usevolt/hcu/ce_mark_hcu.pdf

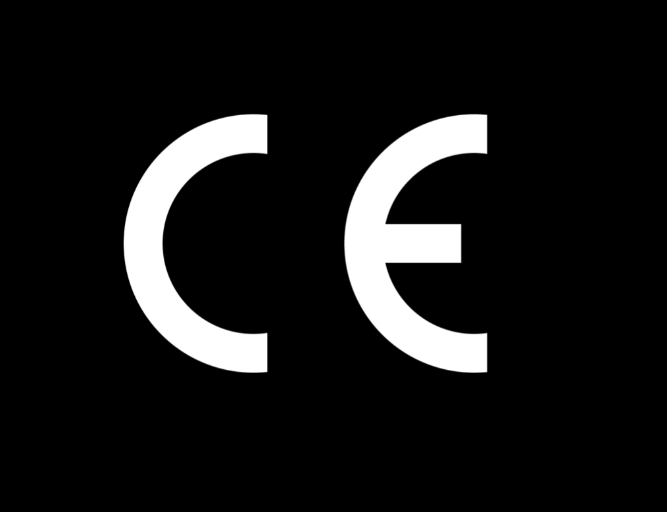
[picture p1: figure]

www.usewood.fi

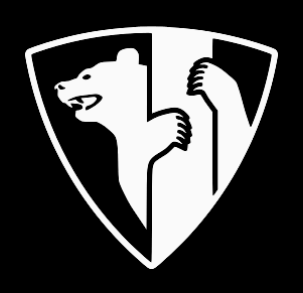
[picture p2: figure]

# Usewood HCU
