usevolt/hcu/ce_mark_hcu_55x20mm.png

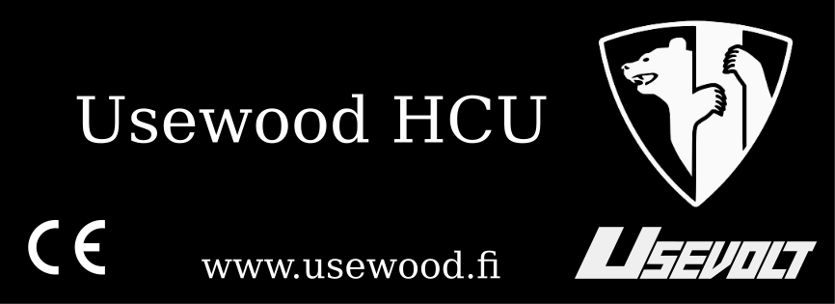
ce_mark_hcu_55x20mm.png
