usevolt/hcu/hw/enclosure_assembly.fcstd

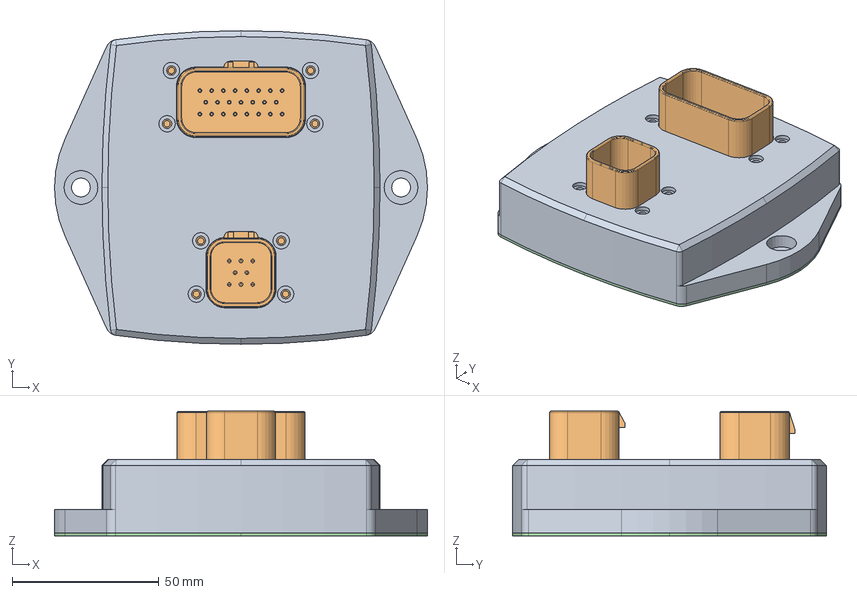
[picture p4: CAD file, 2020-04-29]
hw/enclosure_assembly.fcstd
127.0 x 106.7 x 42.4 mm
enclosure_top_01
hcu_01
hcu_heatsink_01
enclosure_seal_01
