usevolt/hcu/hw/assembly/hcu_enc_top.step

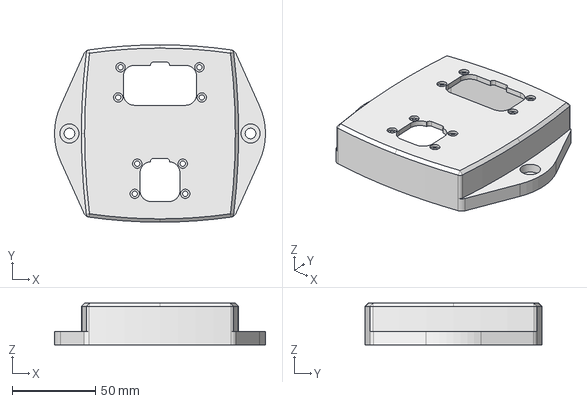
[picture p5: CAD file, 2018-11-07]
hw/assembly/hcu_enc_top.step
127.0 x 106.7 x 25.0 mm
