usevolt/hcu/hw/assembly/hcu_enc_bottom.step

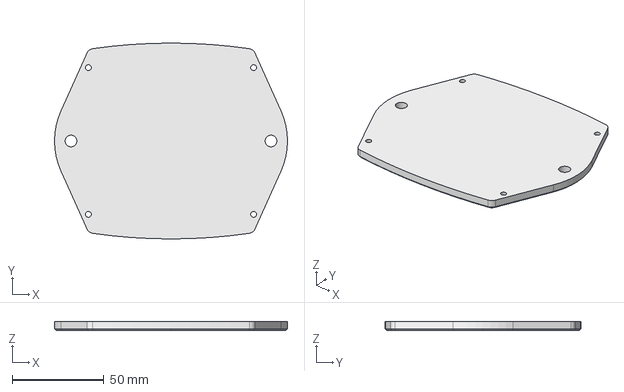
[picture p6: CAD file, 2018-11-07]
hw/assembly/hcu_enc_bottom.step
127.0 x 106.7 x 5.00 mm
