usevolt/hcu/hw/enclosure_seal.fcstd

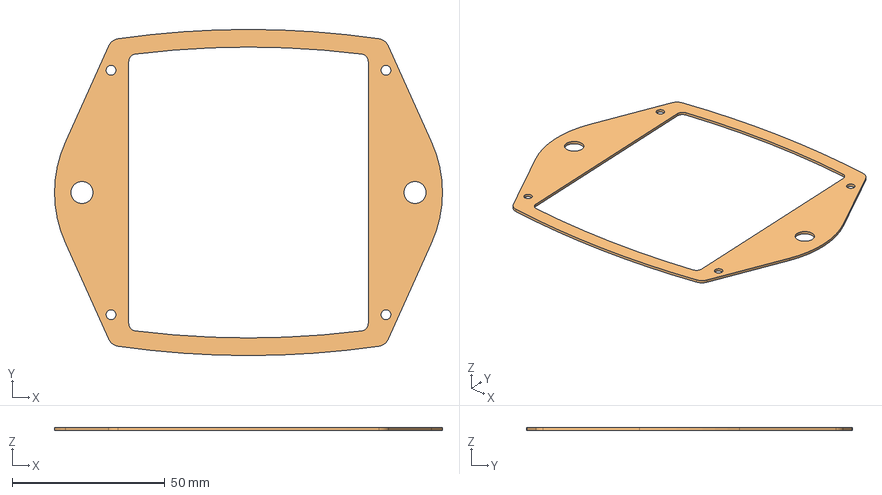
[picture p7: CAD file, 2020-04-29]
hw/enclosure_seal.fcstd
127.0 x 106.7 x 1.00 mm
refine_Fillet
