usevolt/hcu/hw/hcu.FCStd

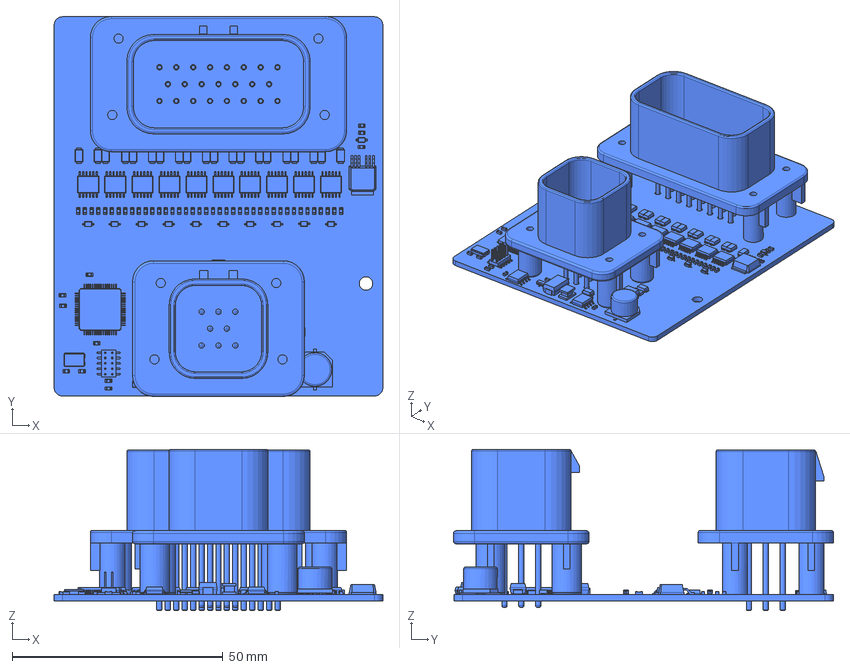
[picture p8: CAD file, 2018-11-07]
hw/hcu.FCStd
78.0 x 90.2 x 38.2 mm
