usevolt/hcu/hw/hcu_heatsink.step

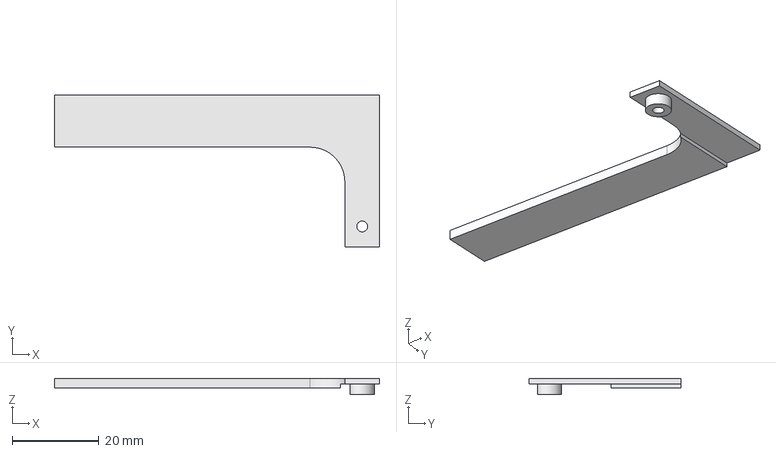
[picture p9: CAD file, 2018-11-07]
hw/hcu_heatsink.step
75.0 x 35.0 x 3.80 mm
