usevolt/hcu/hw/pcb_outline.dxf

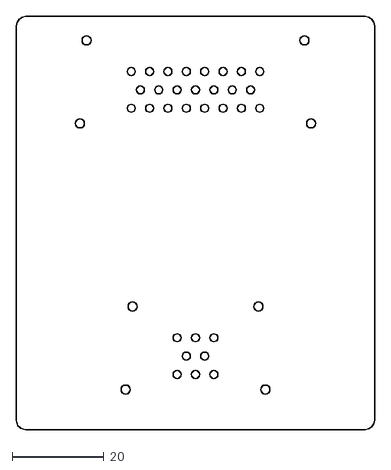
[picture p10: CAD file, 2018-04-24]
hw/pcb_outline.dxf
78.0 x 90.0
