usevolt/hcu/(list of files, cad)

Other CAD files:
hw/enclosure_top.fcstd
hw/enclosure_bottom.fcstd
hw/enclosure_bottom.stl
hw/enclosure_seal.dxf
hw/enclosure_top.stl
hw/hcu_heatsink.fcstd
