usevolt/hcu/hw/assembly/hcu_bottom.pdf

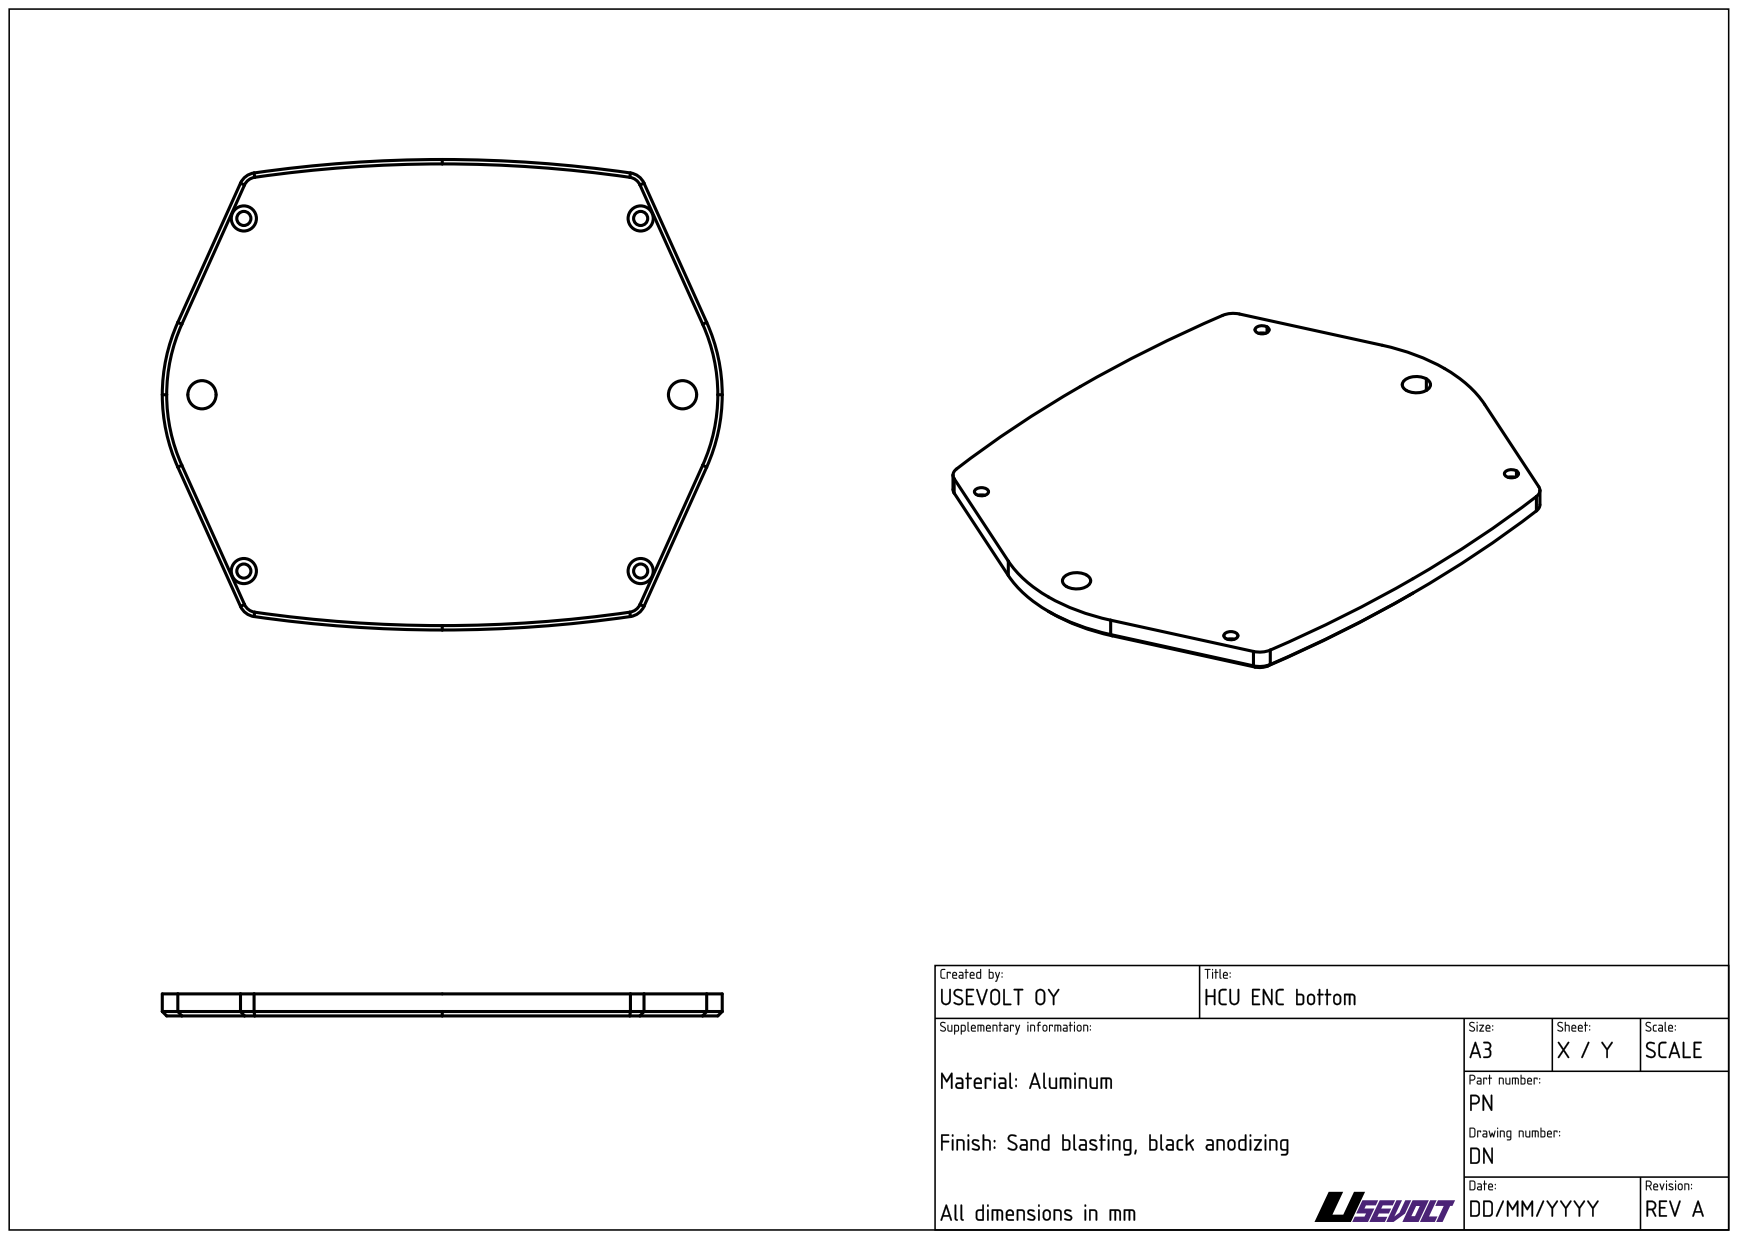
[picture p11: page 1]
