usevolt/hcu/hw/assembly/hcu_enc_top.pdf

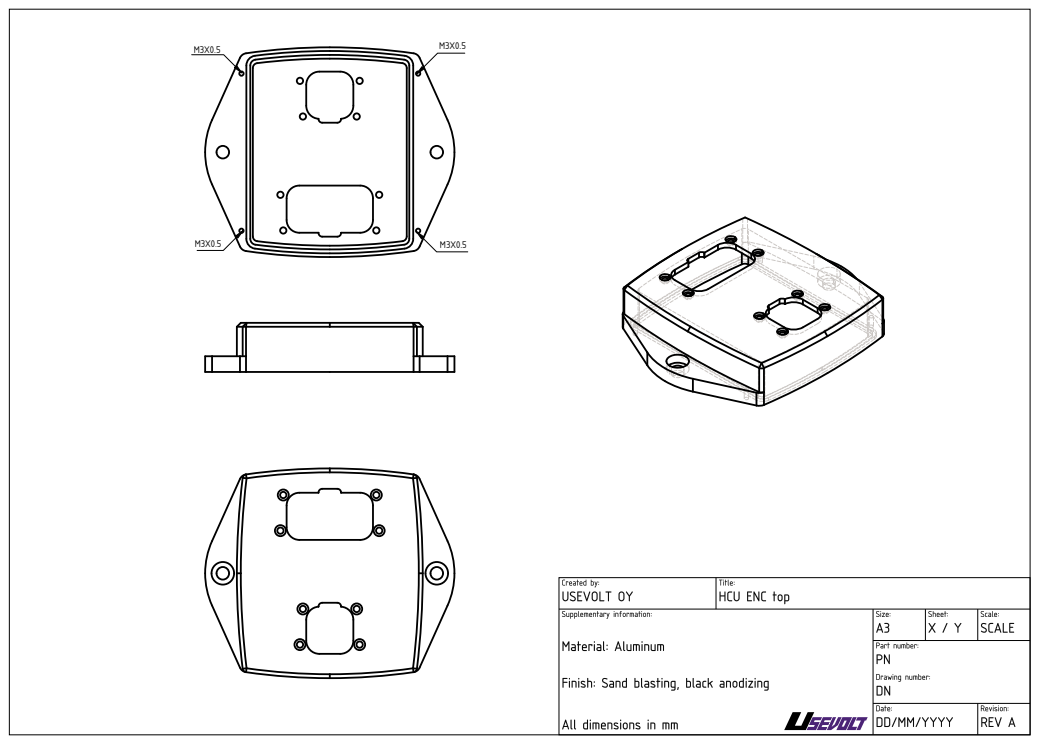
[picture p12: page 1]
