usevolt/hcu/hw/enclosure_seal.pdf

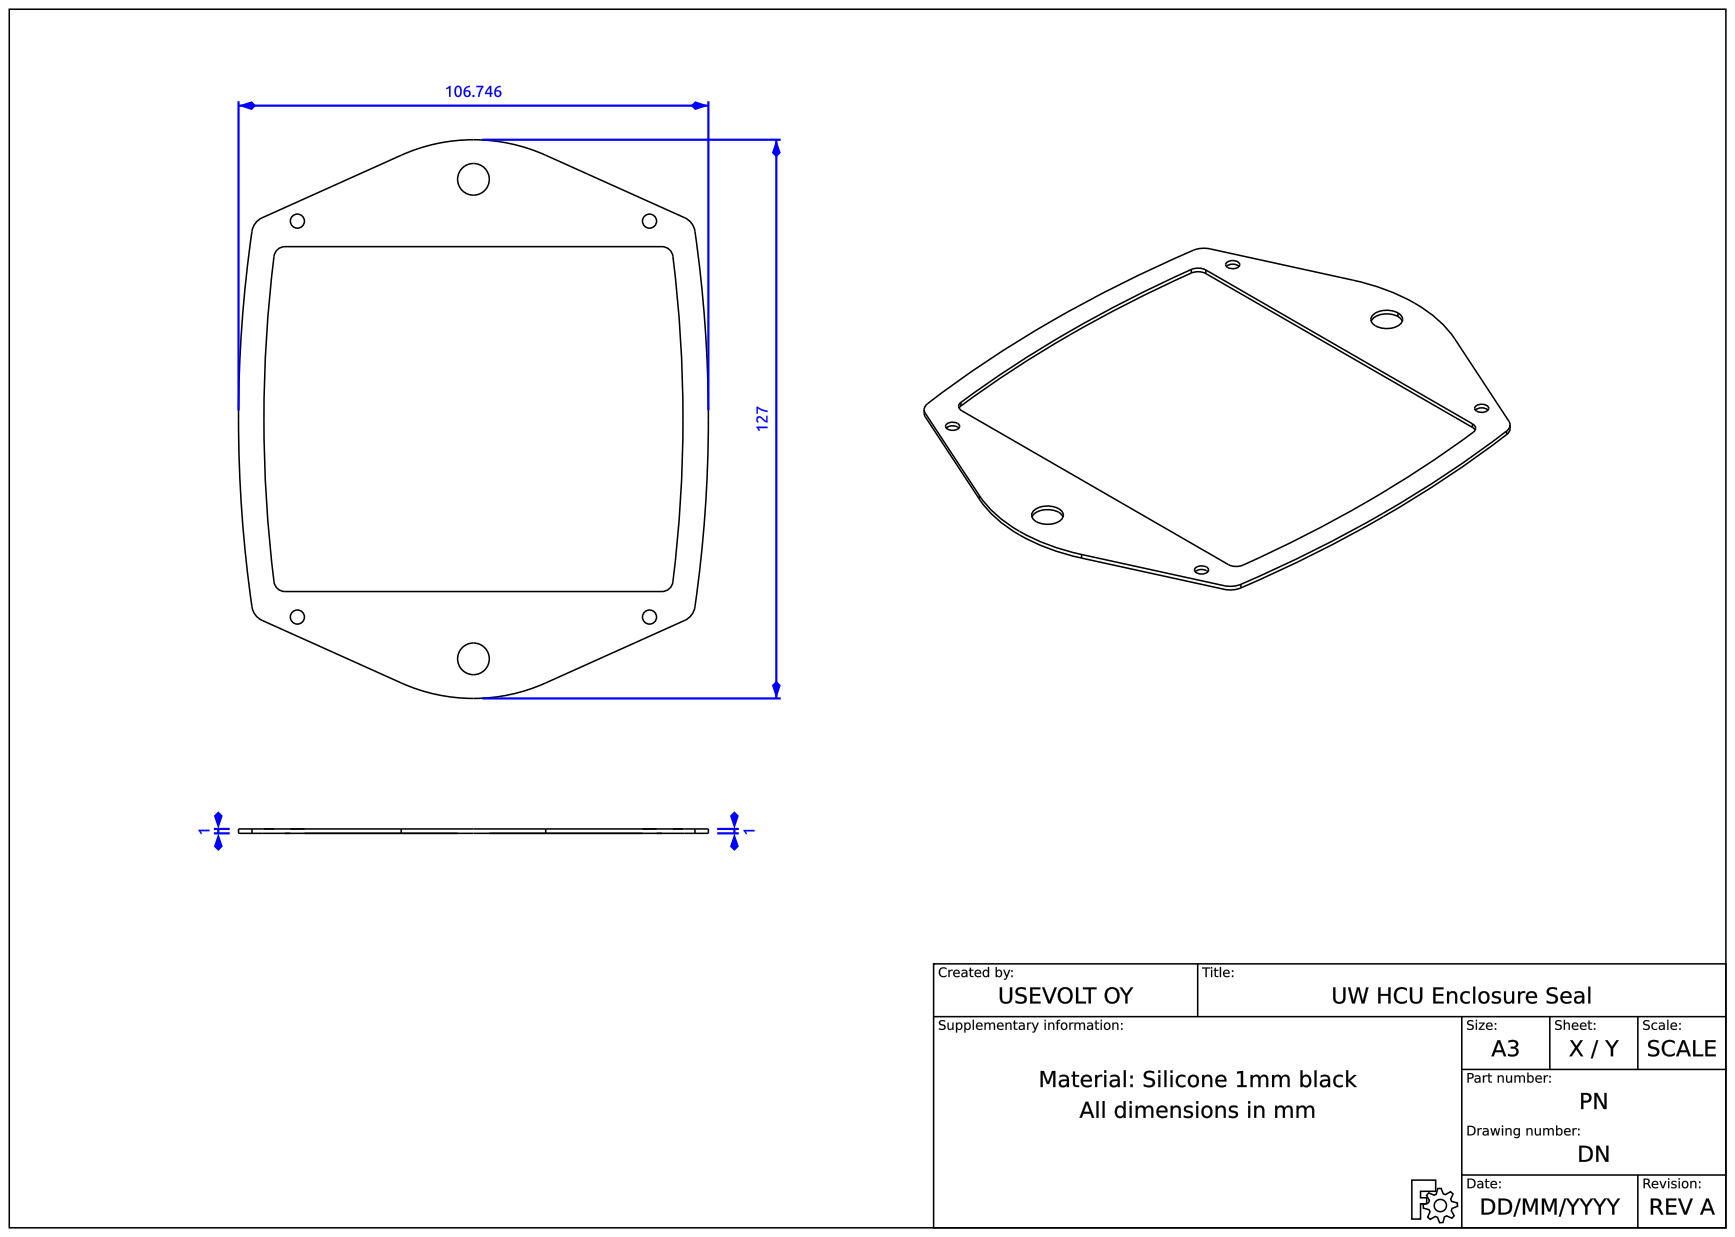
[picture p13: page 1]
