usevolt/hcu/hw/enclosure_threads.pdf

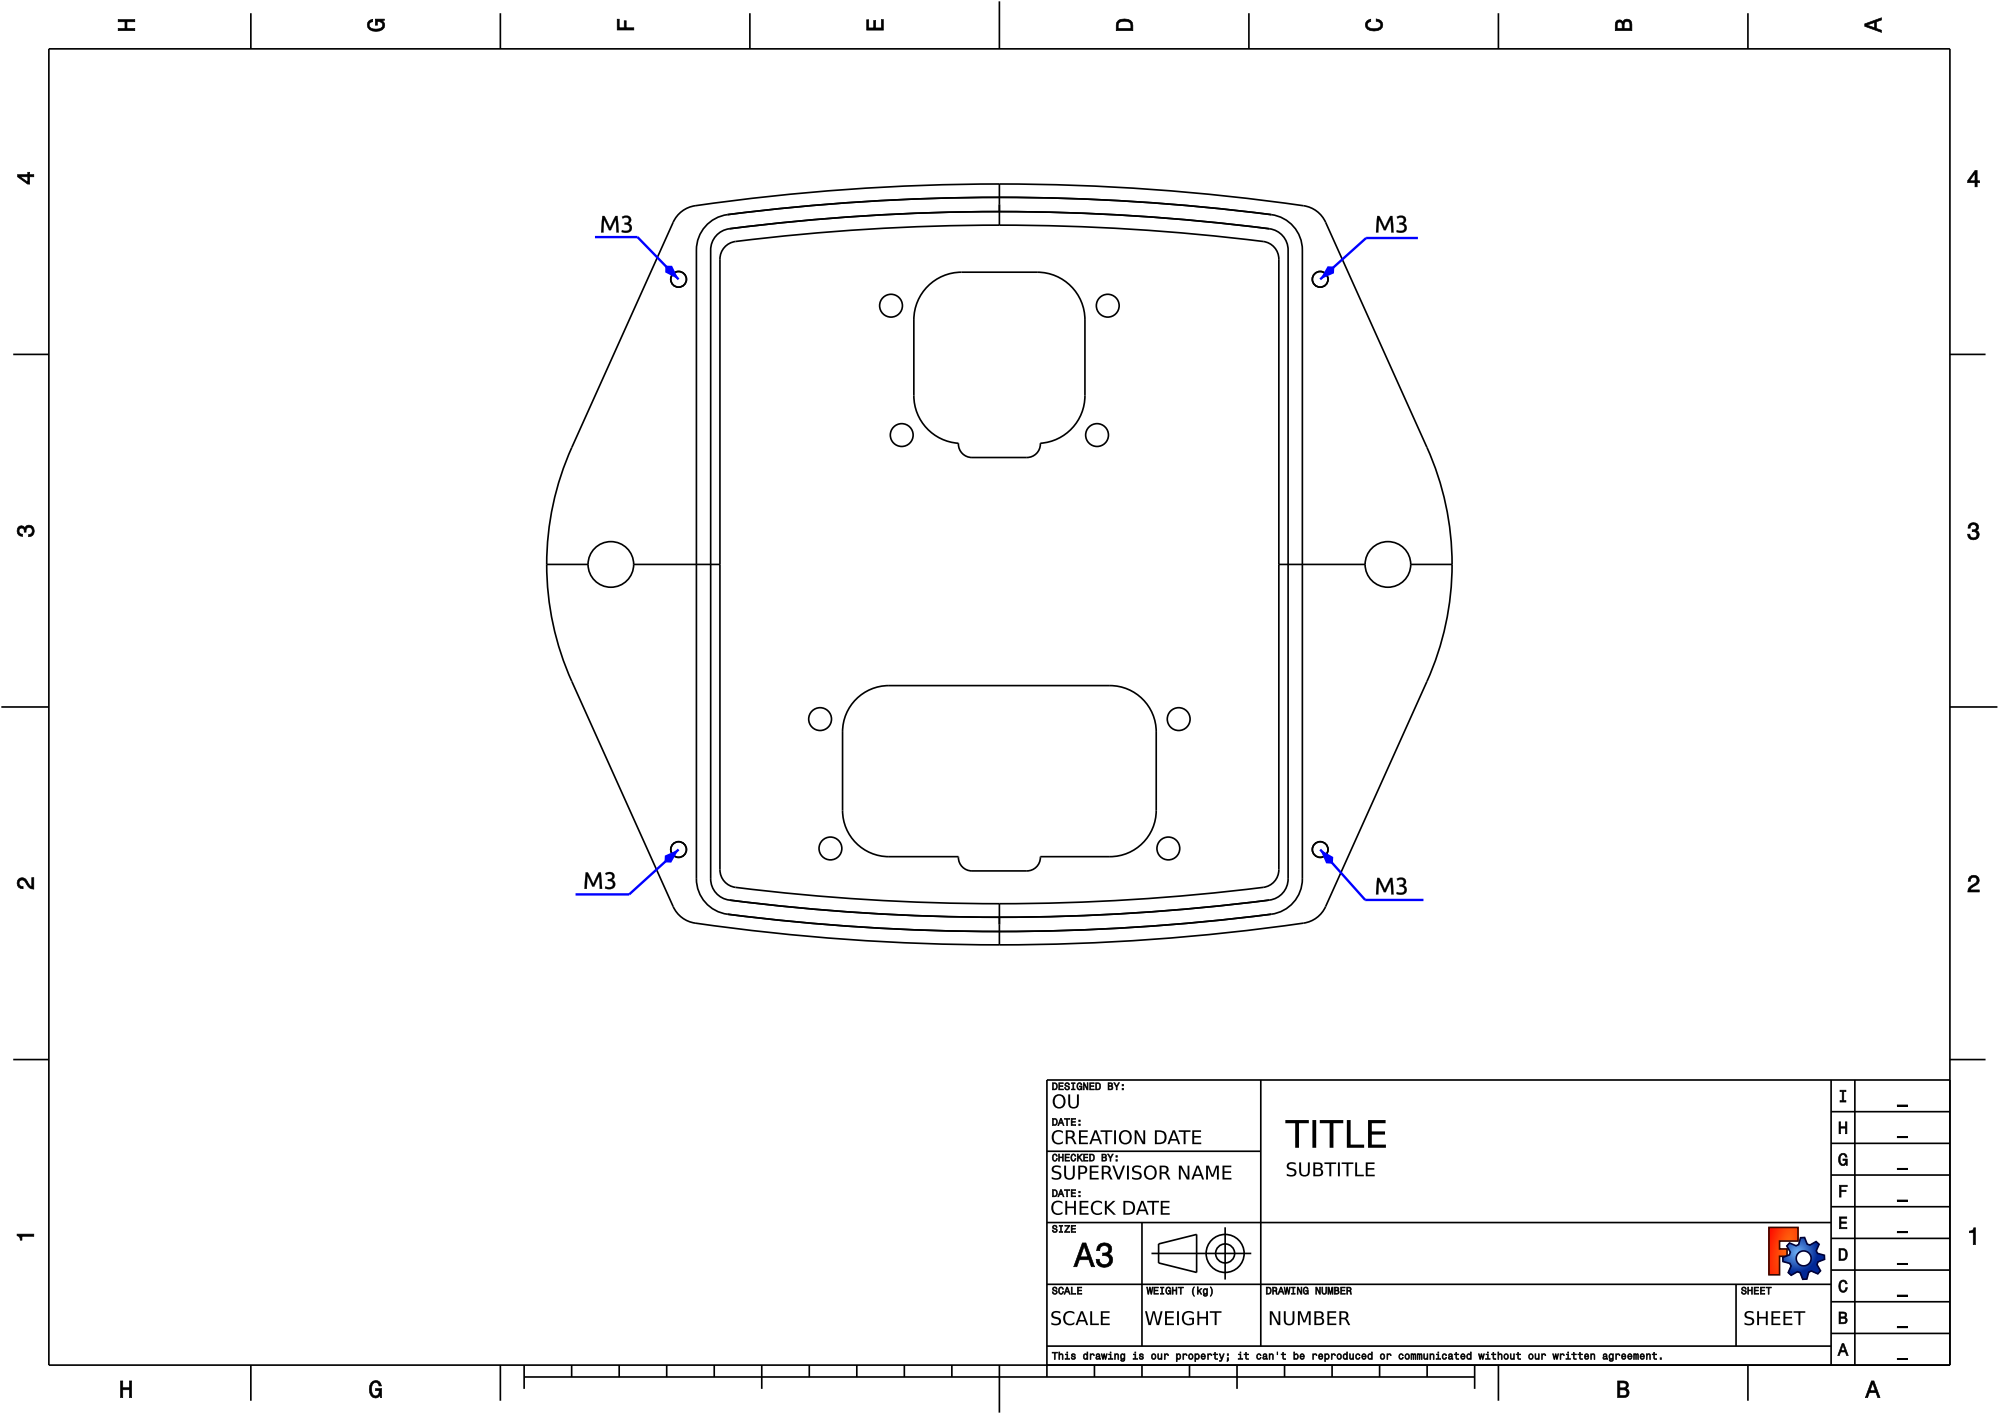
[picture p14: page 1]
