usevolt/hcu/hw/hcu_heatsink.pdf

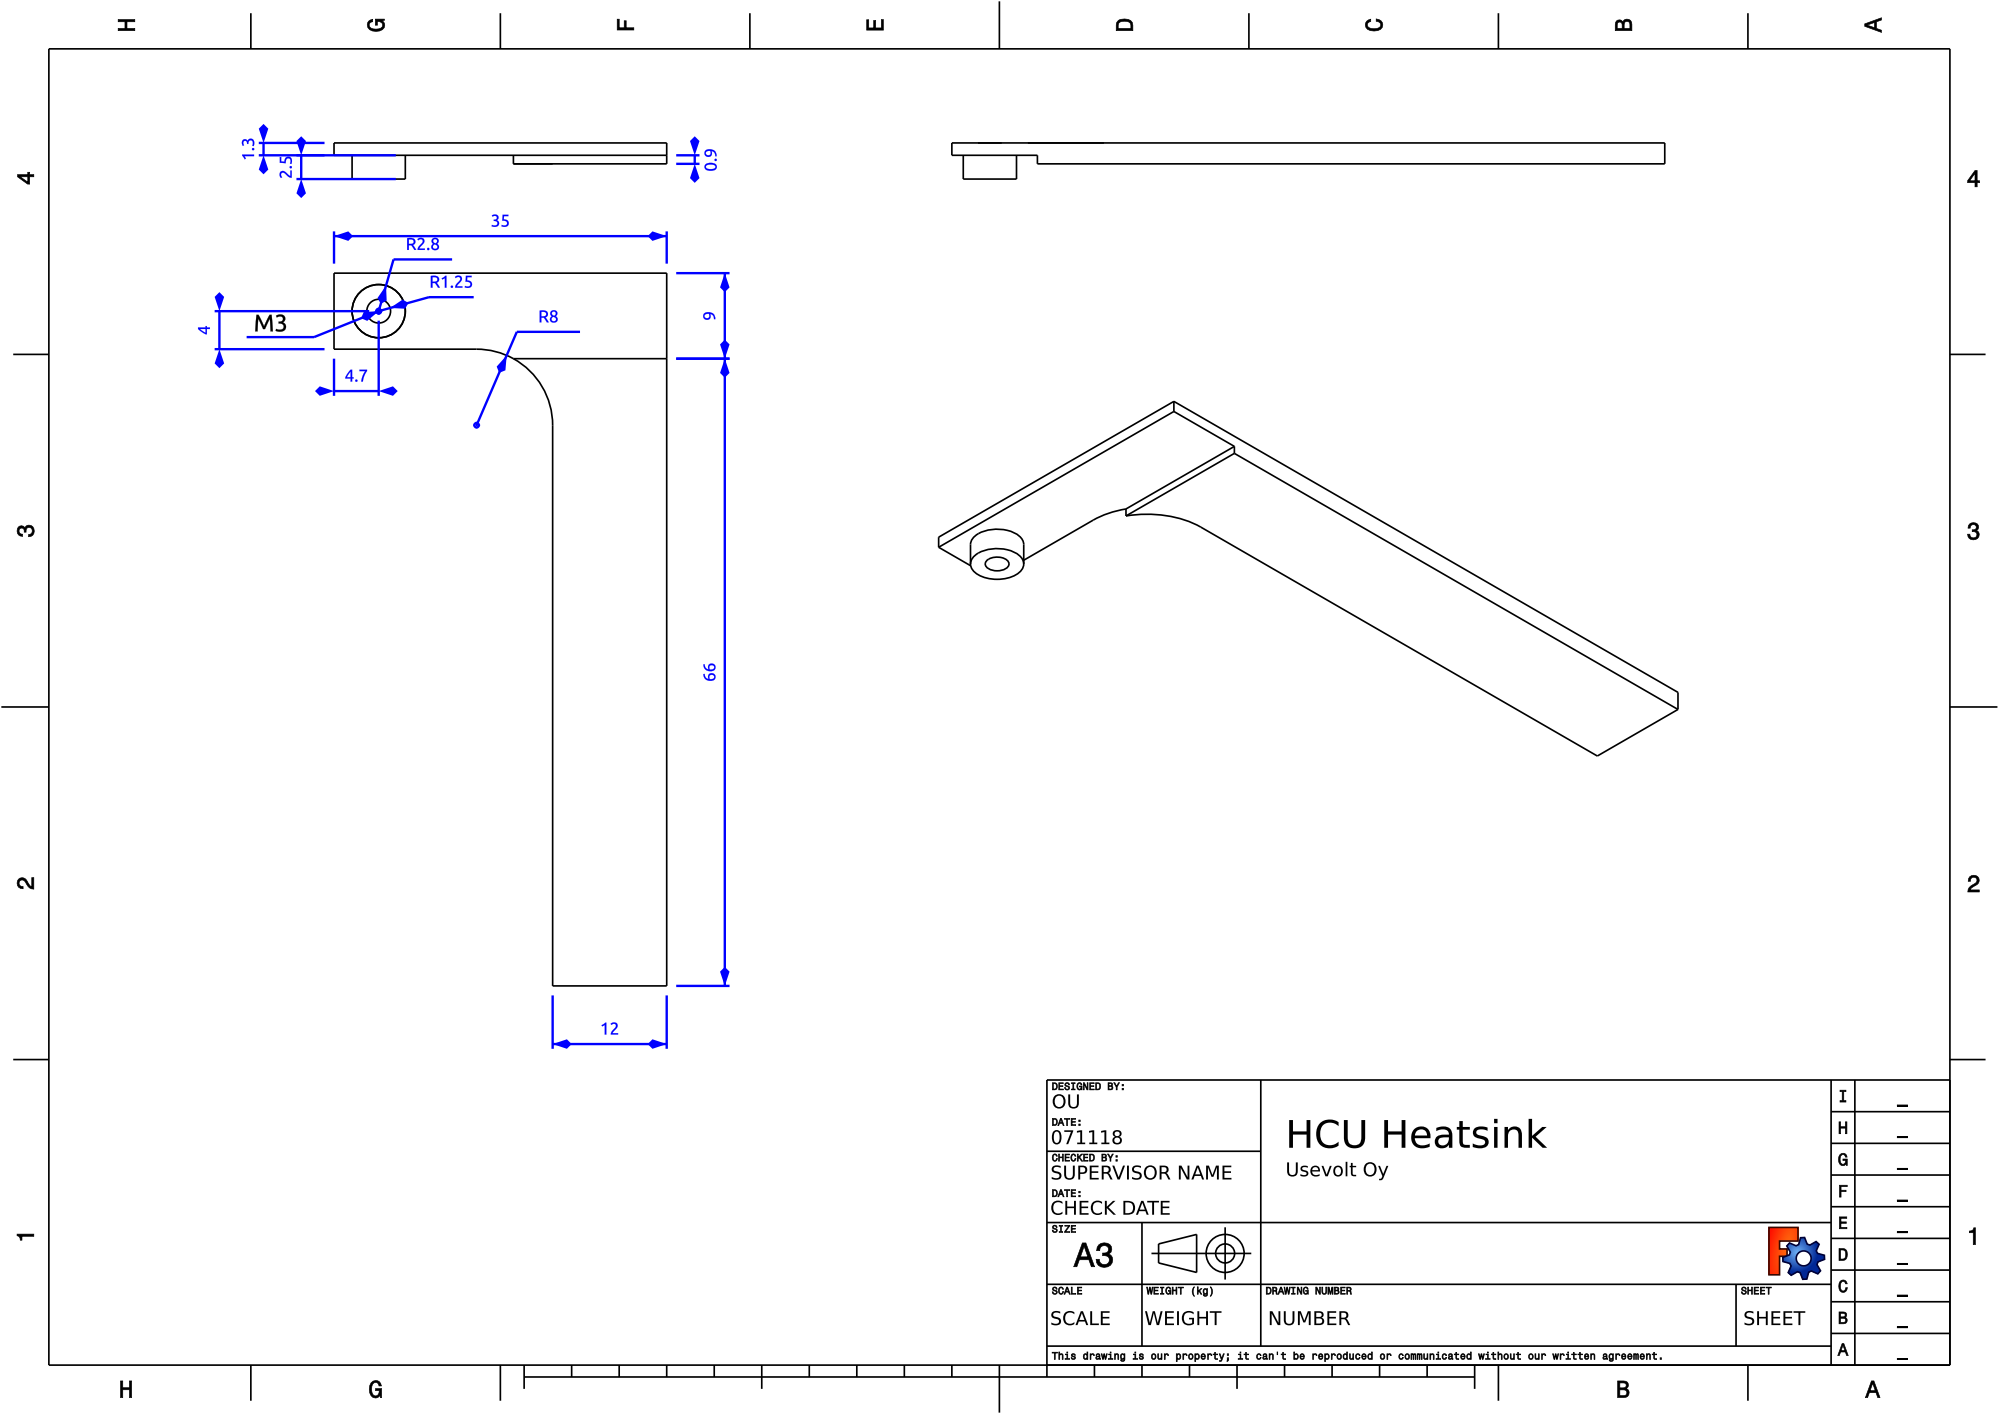
[picture p15: page 1]
