usevolt/hcu/hw/hcu.kicad_pcb

## KiCad design hw/hcu.kicad_pcb (2019-01-24)

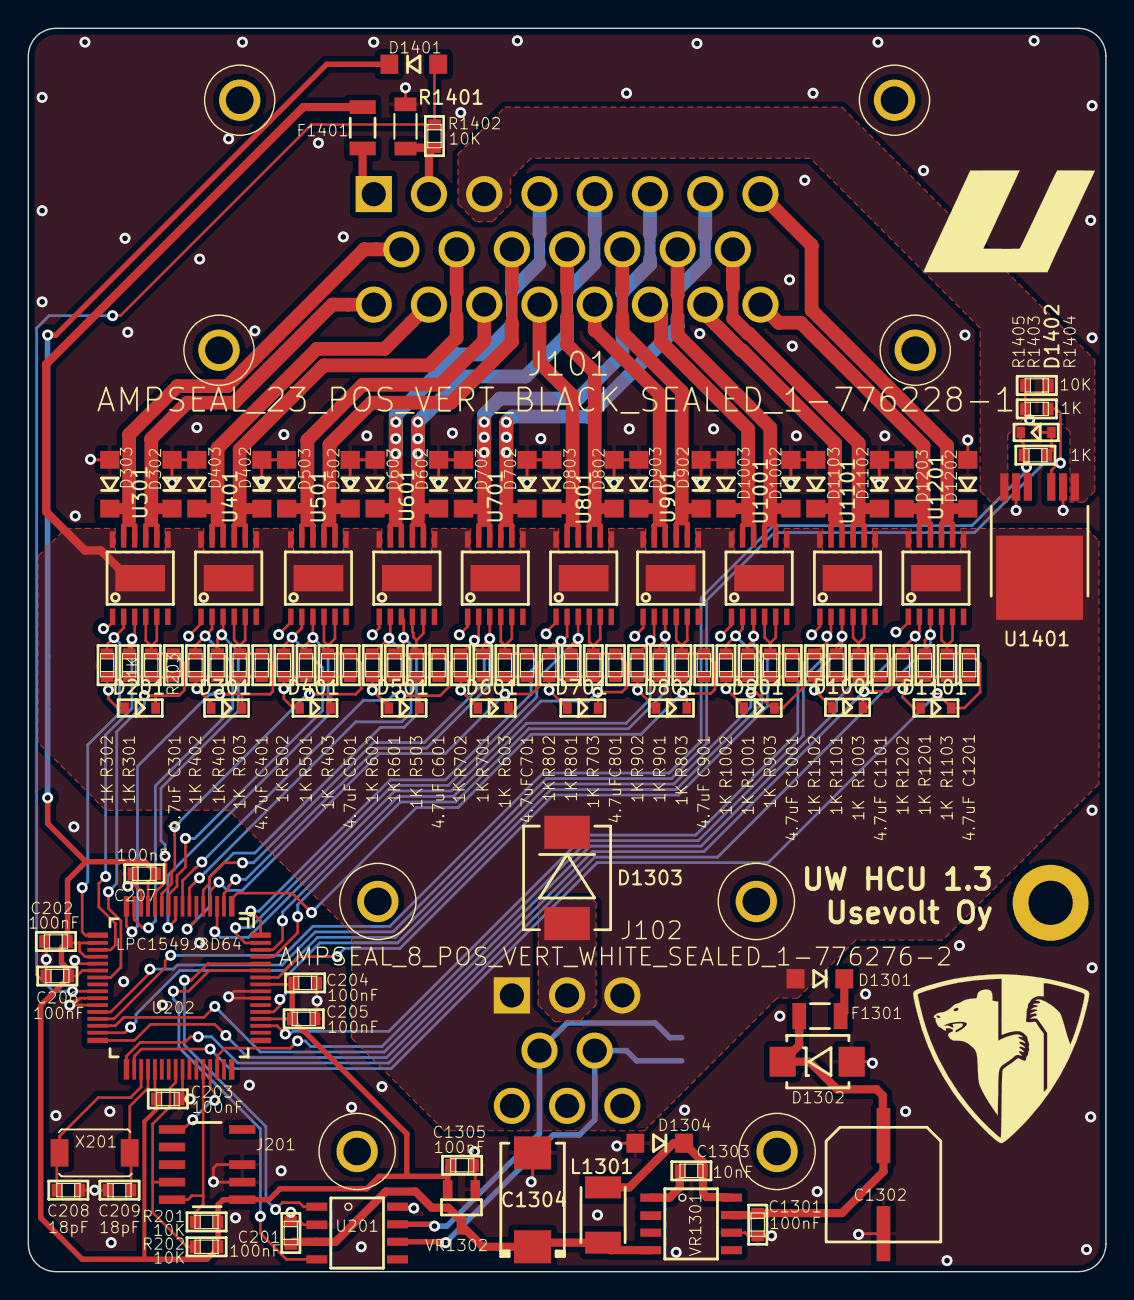
[picture p16: board hcu.kicad_pcb from above]

Board: 2 copper layers, 78.0 x 90.0 mm, 120 parts (1 on the bottom side), 73 nets.

Parts:
C201, C202, C203, C204, C205, C206, C207, C1301, C1305: 100nF; 0603
C208, C209: 18pF; 0603
C301, C401, C501, C601, C701, C801, C901, C1001, C1101, C1201: 4.7uF; 0603
C1302: CAP_EEE-FK1H470P
C1303: 10nF; 0603
C1304: T491D226K035AT; 7343
D201, D301, D401, D501, D601, D701, D801, D901, D1001, D1101, D1402: ZENER_MM3Z3V6T1G; SOD-323
D302, D303, D402, D403, D502, D503, D602, D603, D702, D703, D802, D803, D902, D903, D1002, D1003, D1102, D1103, D1202, D1203, D1301, D1304, D1401: DIODE_RS07J-GS18; DO219AB
D1302: DIODE_TVS_SMBJ33A-TRDO-214AA; DO-214AA
D1303: DIODE_TVS_TPSMD28A; DO-214AB
F1301, F1401: FUSE_MC36211_350MA; FUSE_MC36211
J101: AMPSEAL_23_POS_VERT_BLACK_SEALED_1-776228-1; AMPSEAL_23_POS_776200-1
J102: AMPSEAL_8_POS_VERT_WHITE_SEALED_1-776276-2; AMPSEAL_8_POS_776275-1
J201: ARM_JTAG_SWD_HEADER_10_PINSMD; ARM_10_PIN_JTAG_SWD_CONNECTOR
L1301: IND_744045210
R1: 120; 0603
R201, R202, R1402, R1405: 10K; 0603
R203, R301, R302, R303, R401, R402, R403, R501, R502, R503, R601, R602, R603, R701, R702, R703, R801, R802, R803, R901, R902, R903, R1001, R1002, R1003, R1101, R1102, R1103, R1201, R1202, R1403, R1404: 1K; 0603
R1401: R_75OHM; 1206
U201: MCP2551_SOIC8; SOIC8
U202: LPC1549JBD64; QFP64
U301, U401, U501, U601, U701, U801, U901, U1001, U1101, U1201: VND5050AJTR-E; PowerSSO-12
U1401: VN5E010AH; HPAK
VR1301: LM2671SOIC8; SOIC8
VR1302: REG_MCP1700; SOT-23_3-PIN
X201: XTAL_7A-12.000MAAJ-T; XTAL_7A-20.000MAJ

Connections:
+3V3: C202.1, C203.1, C204.1, C205.1, C206.1, C207.1, C1305.1, D1401.P$2, J201.P$1, R201.2, R202.2, U202.P$13, U202.P$18, U202.P$20, U202.P$22, U202.P$37, U202.P$52, U202.P$57, VR1302.2
+5V: C201.1, C1304.+, L1301.2, U201.3, VR1301.4, VR1302.3
/Sheet5A8D8BD1/IN1: R401.2, U202.P$12, U401.3
/Sheet5A8D8BD1/IN2: R402.2, U202.P$15, U401.2
/Sheet5A8D8BD1/OUT1: D402.P$2, J101.10, U401.8, U401.9
/Sheet5A8D8BD1/OUT2: D403.P$2, J101.17, U401.10, U401.11
/Sheet5A8D9C63/IN1: R701.2, U202.P$2, U701.3
/Sheet5A8D9C63/IN2: R702.2, U202.P$5, U701.2
/Sheet5A8D9C63/OUT1: D702.P$2, J101.7, U701.8, U701.9
/Sheet5A8D9C63/OUT2: D703.P$2, J101.6, U701.10, U701.11
/Sheet5A8D95F2/IN1: R601.2, U202.P$6, U601.3
/Sheet5A8D95F2/IN2: R602.2, U202.P$7, U601.2
/Sheet5A8D95F2/OUT1: D602.P$2, J101.5, U601.8, U601.9
/Sheet5A8D95F2/OUT2: D603.P$2, J101.4, U601.10, U601.11
/Sheet5A8D785F/IN1: R301.2, U202.P$19, U301.3
/Sheet5A8D785F/IN2: R302.2, U202.P$17, U301.2
/Sheet5A8D785F/OUT1: D302.P$2, J101.16, U301.8, U301.9
/Sheet5A8D785F/OUT2: D303.P$2, J101.9, U301.10, U301.11
/Sheet5A8D900E/IN1: R501.2, U202.P$9, U501.3
/Sheet5A8D900E/IN2: R502.2, U202.P$10, U501.2
/Sheet5A8D900E/OUT1: D502.P$2, J101.11, U501.8, U501.9
/Sheet5A8D900E/OUT2: D503.P$2, J101.18, U501.10, U501.11
/Sheet5A8DA46D/IN1: R801.2, U202.P$63, U801.3
/Sheet5A8DA46D/IN2: R802.2, U202.P$64, U801.2
/Sheet5A8DA46D/OUT1: D802.P$2, J101.12, U801.8, U801.9
/Sheet5A8DA46D/OUT2: D803.P$2, J101.19, U801.10, U801.11
/Sheet5A8DB2AC/IN1: R901.2, U202.P$61, U901.3
/Sheet5A8DB2AC/IN2: R902.2, U202.P$62, U901.2
/Sheet5A8DB2AC/OUT1: D902.P$2, J101.13, U901.8, U901.9
/Sheet5A8DB2AC/OUT2: D903.P$2, J101.20, U901.10, U901.11
/Sheet5A8DBBEE/IN1: R1001.2, U202.P$58, U1001.3
/Sheet5A8DBBEE/IN2: R1002.2, U202.P$53, U1001.2
/Sheet5A8DBBEE/OUT1: D1002.P$2, J101.14, U1001.8, U1001.9
/Sheet5A8DBBEE/OUT2: D1003.P$2, J101.21, U1001.10, U1001.11
/Sheet5A8DEA05/IN1: R1101.2, U202.P$46, U1101.3
/Sheet5A8DEA05/IN2: R1102.2, U202.P$51, U1101.2
/Sheet5A8DEA05/OUT1: D1102.P$2, J101.15, U1101.8, U1101.9
/Sheet5A8DEA05/OUT2: D1103.P$2, J101.22, U1101.10, U1101.11
/Sheet5A8DF700/IN1: R1201.2, U202.P$33, U1201.3
/Sheet5A8DF700/IN2: R1202.2, U202.P$30, U1201.2
/Sheet5A8DF700/OUT1: D1202.P$2, J101.8, U1201.8, U1201.9
/Sheet5A8DF700/OUT2: D1203.P$2, J101.23, U1201.10, U1201.11
/Sheet5ABCCFA6/IN1: R1403.2, U202.P$28, U1401.3
/Sheet5ABCCFA6/OUT1: J101.3, R1405.2, U1401.1, U1401.7
/Sheet5AC56778/PRESS_IN: J101.2, R1401.1, R1402.2
/Sheet5AC56778/PRESS_SENSE: D1401.P$1, R1402.1, U202.P$25
/Sheet5AC56778/PRESS_VDD: F1401.P$1, J101.1
/lpc1549/CANH: J102.4, R1.1, U201.7
/lpc1549/CANL: J102.5, R1.2, U201.6
/lpc1549/CAN_RX: U201.4, U202.P$59
/lpc1549/CAN_TX: U201.1, U202.P$60
/lpc1549/OUT1_SENSE: C301.2, D201.1, R203.1, U202.P$23, U301.4, U301.5
/lpc1549/OUT2_SENSE: C401.2, D301.1, R303.1, U202.P$16, U401.4, U401.5
/lpc1549/OUT3_SENSE: C501.2, D401.1, R403.1, U202.P$11, U501.4, U501.5
/lpc1549/OUT4_SENSE: C601.2, D501.1, R503.1, U202.P$8, U601.4, U601.5
/lpc1549/OUT5_SENSE: C701.2, D601.1, R603.1, U202.P$4, U701.4, U701.5
/lpc1549/OUT6_SENSE: C801.2, D701.1, R703.1, U202.P$3, U801.4, U801.5
/lpc1549/OUT7_SENSE: C901.2, D801.1, R803.1, U202.P$1, U901.4, U901.5
/lpc1549/OUT8_SENSE: C1001.2, D901.1, R903.1, U202.P$31, U1001.4, U1001.5
/lpc1549/OUT9_SENSE: C1101.2, D1001.1, R1003.1, U202.P$32, U1101.4, U1101.5
/lpc1549/OUT10_SENSE: C1201.2, D1101.1, R1103.1, U202.P$34, U1201.4, U1201.5
/lpc1549/OUT11_SENSE: D1402.1, R1404.1, U202.P$29, U1401.5
/lpc1549/RESET: J201.P$9, U202.P$45
GND: C201.2, C202.2, C203.2, C204.2, C205.2, C206.2, C207.2, C208.2, C209.2, C301.1, C401.1, C501.1, C601.1, C701.1, C801.1, C901.1, C1001.1, C1101.1, C1201.1, C1301.2, C1302.-, C1304.-, C1305.2, D201.2, D301.2, D302.P$1, D303.P$1, D401.2, D402.P$1, D403.P$1, D501.2, D502.P$1, D503.P$1, D601.2, D602.P$1, D603.P$1, D701.2, D702.P$1, D703.P$1, D801.2, D802.P$1, D803.P$1, D901.2, D902.P$1, D903.P$1, D1001.2, D1002.P$1, D1003.P$1, D1101.2, D1102.P$1, D1103.P$1, D1202.P$1, D1203.P$1, D1302.P$1, D1303.1, D1304.P$1, D1402.2, J102.2, J201.P$3, J201.P$5, R203.2, R301.1, R302.1, R303.2, R401.1, R402.1, R403.2, R501.1, R502.1, R503.2, R601.1, R602.1, R603.2, R701.1, R702.1, R703.2, R801.1, R802.1, R803.2, R901.1, R902.1, R903.2, R1001.1, R1002.1, R1003.2, R1101.1, R1102.1, R1103.2, R1201.1, R1202.1, R1401.2, R1403.1, R1404.2, R1405.1, U201.2, U201.8, U202.P$14, U202.P$21, U202.P$26, U202.P$27, U202.P$41, U202.P$55, U202.P$56, U301.1, U401.1, U501.1, U601.1, U701.1, U801.1, U901.1, U1001.1, U1101.1, U1201.1, U1401.2, U1401.6, VR1301.6, VR1302.1
unnamed: C208.1, U202.P$35, X201.P$1
unnamed: C209.1, U202.P$36, X201.P$2
unnamed: C1301.1, C1302.+, D1302.P$2, F1301.P$2, VR1301.7
unnamed: C1303.1, VR1301.1
unnamed: C1303.2, D1304.P$2, L1301.1, VR1301.8
unnamed: D1301.P$2, F1301.P$1
unnamed: J201.P$2, R201.1, U202.P$44
unnamed: J201.P$4, R202.1, U202.P$40
VDD: D1301.P$1, D1303.2, F1401.P$2, J102.1, J102.3, U301.7, U301.12, U301.13, U401.7, U401.12, U401.13, U501.7, U501.12, U501.13, U601.7, U601.12, U601.13, U701.7, U701.12, U701.13, U801.7, U801.12, U801.13, U901.7, U901.12, U901.13, U1001.7, U1001.12, U1001.13, U1101.7, U1101.12, U1101.13, U1201.7, U1201.12, U1201.13, U1401.4
