usevolt/hcu/sw/src/modules/rotator.c

/* 
 * This file is part of the uv_hal distribution (www.usevolt.fi).
 * Copyright (c) 2017 Usevolt Oy.
 * 
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
 * You should have received a copy of the GNU General Public License 
 * along with this program. If not, see <http://www.gnu.org/licenses/>.
*/





#include "rotator.h"
#include "main.h"
#include "pin_mappings.h"
#include "can_keypad.h"
#include <uv_rtos.h>


void rotator_conf_reset(rotator_conf_st *this) {
	this->out_conf.acc = 96;
	this->out_conf.dec = 96;
	this->out_conf.invert = true;
	this->out_conf.assembly_invert = false;
	this->out_conf.solenoid_conf[DUAL_OUTPUT_SOLENOID_A].max_ma = 300;
	this->out_conf.solenoid_conf[DUAL_OUTPUT_SOLENOID_A].min_ma = 80;
	this->out_conf.solenoid_conf[DUAL_OUTPUT_SOLENOID_B].max_ma = 300;
	this->out_conf.solenoid_conf[DUAL_OUTPUT_SOLENOID_B].min_ma = 80;
}


void rotator_init(rotator_st *this, rotator_conf_st *conf_ptr) {
	input_init(&this->input);

	this->conf = conf_ptr;

	uv_dual_solenoid_output_init(&this->out, &conf_ptr->out_conf, ROTATOR_PWMA,
			ROTATOR_PWMB, ROTATOR_SENSE, dev.dither_freq, dev.dither_ampl,
			VND5050_CURRENT_AMPL_UA, SOLENOID_MAX_CURRENT, SOLENOID_FAULT_CURRENT,
			HCU_EMCY_ROTATOR_OVERLOAD_A, HCU_EMCY_ROTATOR_OVERLOAD_B,
			HCU_EMCY_ROTATOR_FAULT_A, HCU_EMCY_ROTATOR_FAULT_B);
}


void rotator_step(rotator_st *this, uint16_t step_ms) {
	input_step(&this->input, step_ms);

	canopen_pdo_mapping_parameter_st *map;


	uv_disable_int();
	if (dev.implement == HCU_IMPLEMENT_UW180S ||
			dev.implement == HCU_IMPLEMENT_UW100 ||
			dev.implement == HCU_IMPLEMENT_HYDOUTPUT) {
		// remap rotator to right joystick x
		map = uv_canopen_rxpdo_get_mapping(CANOPEN_TXPDO1_ID + RKEYPAD_NODE_ID);
		if (map != NULL) {
			map->mappings[0].main_index = HCU_ROTATOR_REQ_INDEX;
			map->mappings[0].sub_index = HCU_ROTATOR_REQ_SUBINDEX;
		}
		// only clear mapping if implement is not UW100 or hydout,
		// since boom telescope might need this button
		if (dev.implement != HCU_IMPLEMENT_UW100 &&
				dev.implement != HCU_IMPLEMENT_HYDOUTPUT &&
				dev.implement != HCU_IMPLEMENT_UW180S) {
			map = uv_canopen_rxpdo_get_mapping(CANOPEN_TXPDO1_ID + LKEYPAD_NODE_ID);
			if (map != NULL) {
				map->mappings[4].main_index = 0;
				map->mappings[4].sub_index = 0;
			}
		}
	}
	else if (dev.implement == HCU_IMPLEMENT_UW50) {
		// remap rotator to left joystick z
		map = uv_canopen_rxpdo_get_mapping(CANOPEN_TXPDO1_ID + RKEYPAD_NODE_ID);
		if (map != NULL) {
			map->mappings[0].main_index = 0;
			map->mappings[0].sub_index = 0;
		}
		map = uv_canopen_rxpdo_get_mapping(CANOPEN_TXPDO1_ID + LKEYPAD_NODE_ID);
		if (map != NULL) {
			map->mappings[4].main_index = HCU_ROTATOR_REQ_INDEX;
			map->mappings[4].sub_index = HCU_ROTATOR_REQ_SUBINDEX;
		}
	}
	else {

	}
	uv_enable_int();

	int16_t req = input_get_request(&this->input, &this->conf->out_conf);
	// rotator is disabled for all others than UW50 while driving
	if (dev.implement != HCU_IMPLEMENT_UW50) {
		if (dev.ccu.drive_req) {
			req = 0;
		}
		else {
			req = input_get_request(&this->input, &this->conf->out_conf);
		}
	}

	uv_dual_solenoid_output_set(&this->out, req);



}
