usevolt/hcu/(commit log)

2018-02-06 hcu initial revision
    [hcu.kicad_pcb, hcu.sch, lpc1549.sch, pwr_supply_sheet.sch, vn5e010ah.sch, vnd5050.sch]
2018-03-30 1.0 pcb created
    [hcu-2018-03-28-08-59-09.sch, lpc1549-2018-03-28-08-59-09.sch, lpc1549.sch, press_sensor.sch, pwr_supply_sheet-2018-03-28-08-59-09.sch, pwr_supply_sheet.sch, vn5e010ah.sch, vnd5050-2018-03-28-08-59-09.sch]
2018-04-24 first revision ordered from seeed
    [enclosure_bottom.fcstd, enclosure_bottom.stl, enclosure_top.fcstd, enclosure_top.stl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]
2018-07-01 hw 2.0.0 ordered
    [enclosure_bottom.fcstd, enclosure_bottom.stl, enclosure_top.fcstd, enclosure_top.step, enclosure_top.stl]
2018-07-01 ampseal 8 pin changed to white one
    [hcu.kicad_pcb, hcu.sch]
2018-07-04 enclosure 3.0, for cnc machining ready
    [enclosure_bottom.fcstd, enclosure_top.fcstd]
2018-08-07 boom and legs work ,pressure no
2018-08-15 pull down resistor and flyback diode added to out11
    [hcu.kicad_pcb, vn5e010ah.sch, vnd5050.sch]
2018-09-18 boom telescope mapped to right keypad button
2018-10-04 sense protection diodes changed to zeners
    [hcu-B.Cu.gbl, hcu-B.Mask.gbs, hcu-B.SilkS.gbo, hcu-Edge.Cuts.gm1, hcu-F.Cu.gtl, hcu-F.Paste.gtp, hcu-F.SilkS.gto, hcu-NPTH.drl]
2018-11-02 mutex added to main in order to prevent occassional movement freezing
    [main.c]
2018-11-07 enclosure ready for cnc'd, added heatsink to mosfets
    [enclosure_assembly.fcstd, enclosure_bottom.fcstd, enclosure_bottom.step, enclosure_top.fcstd, enclosure_top.step, hcu.FCStd, hcu.kicad_pcb, hcu_heatsink.fcstd]
2018-11-22 possible hardfault fix:
    interrupts disabled when accessing PDO parameters
    [boom_telescope.c, impl1.c, main.c, rotator.c]
2018-12-21 pcb 1.2.0 created, with heatsink attachment hole
    [hcu-B.Cu.gbl, hcu-B.Mask.gbs, hcu-B.SilkS.gbo, hcu-Edge.Cuts.gm1, hcu-F.Cu.gtl, hcu-F.Mask.gts, hcu-F.Paste.gtp, hcu-F.SilkS.gto]
2019-01-02 trying to fix a bug regarding when some movements are left on
    [impl1.c, impl2.c, main.c]
2019-01-02 step funciton priority is bigger than solenoid_step
2019-01-24 pcb 1.3.0 created
    [hcu-B.Cu.gbl, hcu-B.Mask.gbs, hcu-B.SilkS.gbo, hcu-Edge.Cuts.gm1, hcu-F.Cu.gtl, hcu-F.Mask.gts, hcu-F.SilkS.gto, hcu-NPTH.drl]
2019-02-10 wdt implemented to prevent freezing with all movements ON
    [main.c]
2019-06-09 boom rotate disabled while driving when back steering is enabled
2019-08-09 printf debug removed from boom_telescope
2019-08-23 major bugfix: hcu restarting fixed by disabling interrupts when adc is making a conversion
    [main.c]
2019-09-10 Major bugfix: pressure sensing uses median adc reading to prevent glitches
    [boom_rotate.c, impl2.c, main.c]
2019-09-10 complies with uw180s icu tilt on right keypad button 7:
    boom telescope is on left thumb on uw180s
2020-04-29 seal created for enclosure
    [enclosure_assembly.fcstd, enclosure_seal.dxf, enclosure_seal.fcstd]
2020-12-28 work rpm req implemented for stage5 engine
2021-01-09 assembly directory added for enclosure files
    [enclosure_bottom.fcstd, enclosure_top.fcstd, hcu_enc_bottom.step, hcu_enc_top.step]
