usevolt/hcu/(notices)

Notices in the files:
sw/inc/out_mappings.h:
This program is free software: you can redistribute it and/or modify
it under the terms of the GNU General Public License as published by
the Free Software Foundation, version 3.
